brupje/minitronics_20/Design Files/readme.md

Design files for Minitronics v2. You can use DesignSpark software to open these.
