brupje/minitronics_20/(list of files, drawings)

Other design files:
Design Files/minitronics.pcb
