brupje/minitronics_20/Examples/minitronics20-CardInfo/minitronics20-CardInfo.ino

/*
  SD card test

  This example shows how use the utility libraries on which the'
  SD library is based in order to get info about your SD card.
  Very useful for testing a card when you're not sure whether its working or not.

  The circuit:
    SD card attached to SPI bus as follows:
 ** MOSI - pin 11 on Arduino Uno/Duemilanove/Diecimila
 ** MISO - pin 12 on Arduino Uno/Duemilanove/Diecimila
 ** CLK - pin 13 on Arduino Uno/Duemilanove/Diecimila
 ** CS - depends on your SD card shield or module.
 		Pin 4 used here for consistency with other Arduino examples


  created  28 Mar 2011
  by Limor Fried
  modified 9 Apr 2012
  by Tom Igoe
*/
// include the SD library:
#include <SPI.h>
#include <SD.h>

// set up variables using the SD utility library functions:
Sd2Card card;
SdVolume volume;
SdFile root;

// change this to match your SD shield or module;
// Arduino Ethernet shield: pin 4
// Adafruit SD shields and modules: pin 10
// Sparkfun SD shield: pin 8
// MKRZero SD: SDCARD_SS_PIN
const int chipSelect = 2;

void setup() {
  // Open SerialUSB communications and wait for port to open:
  SerialUSB.begin(115200);
  while (!SerialUSB) {
    ; // wait for SerialUSB port to connect. Needed for native USB port only
  }


  SerialUSB.print("\nInitializing SD card...");

  // we'll use the initialization code from the utility libraries
  // since we're just testing if the card is working!
  if (!card.init(SPI_HALF_SPEED, chipSelect)) {
    SerialUSB.println("initialization failed. Things to check:");
    SerialUSB.println("* is a card inserted?");
    SerialUSB.println("* is your wiring correct?");
    SerialUSB.println("* did you change the chipSelect pin to match your shield or module?");
    while (1);
  } else {
    SerialUSB.println("Wiring is correct and a card is present.");
  }

  // print the type of card
  SerialUSB.println();
  SerialUSB.print("Card type:         ");
  switch (card.type()) {
    case SD_CARD_TYPE_SD1:
      SerialUSB.println("SD1");
      break;
    case SD_CARD_TYPE_SD2:
      SerialUSB.println("SD2");
      break;
    case SD_CARD_TYPE_SDHC:
      SerialUSB.println("SDHC");
      break;
    default:
      SerialUSB.println("Unknown");
  }

  // Now we will try to open the 'volume'/'partition' - it should be FAT16 or FAT32
  if (!volume.init(card)) {
    SerialUSB.println("Could not find FAT16/FAT32 partition.\nMake sure you've formatted the card");
    while (1);
  }

  SerialUSB.print("Clusters:          ");
  SerialUSB.println(volume.clusterCount());
  SerialUSB.print("Blocks x Cluster:  ");
  SerialUSB.println(volume.blocksPerCluster());

  SerialUSB.print("Total Blocks:      ");
  SerialUSB.println(volume.blocksPerCluster() * volume.clusterCount());
  SerialUSB.println();

  // print the type and size of the first FAT-type volume
  uint32_t volumesize;
  SerialUSB.print("Volume type is:    FAT");
  SerialUSB.println(volume.fatType(), DEC);

  volumesize = volume.blocksPerCluster();    // clusters are collections of blocks
  volumesize *= volume.clusterCount();       // we'll have a lot of clusters
  volumesize /= 2;                           // SD card blocks are always 512 bytes (2 blocks are 1KB)
  SerialUSB.print("Volume size (Kb):  ");
  SerialUSB.println(volumesize);
  SerialUSB.print("Volume size (Mb):  ");
  volumesize /= 1024;
  SerialUSB.println(volumesize);
  SerialUSB.print("Volume size (Gb):  ");
  SerialUSB.println((float)volumesize / 1024.0);

  SerialUSB.println("\nFiles found on the card (name, date and size in bytes): ");
  root.openRoot(volume);

  // list all files in the card with date and size
  root.ls(LS_R | LS_DATE | LS_SIZE);
}

void loop(void) {
}
