brupje/minitronics_20/(commit log)

2018-10-05 Creation. Added examples for Arduino to test minitronics
2018-12-19 Design files for Minitronics v2.0
    [minitronics.sch, ~minitronics.pcb]
2022-10-29 Fix PCB file Add test form reprapworld graphical LCD +SD (HW SPI)
    [minitronics.pcb, minitronics.sch, ~minitronics.pcb]
2024-02-13 Add klipper firmware
